CameronBrooks11/cubesat-pc104-kicad/breakout/CSK_Bus_Breakout.kicad_sch

## KiCad design breakout/CSK_Bus_Breakout.kicad_sch (2026-11-14)

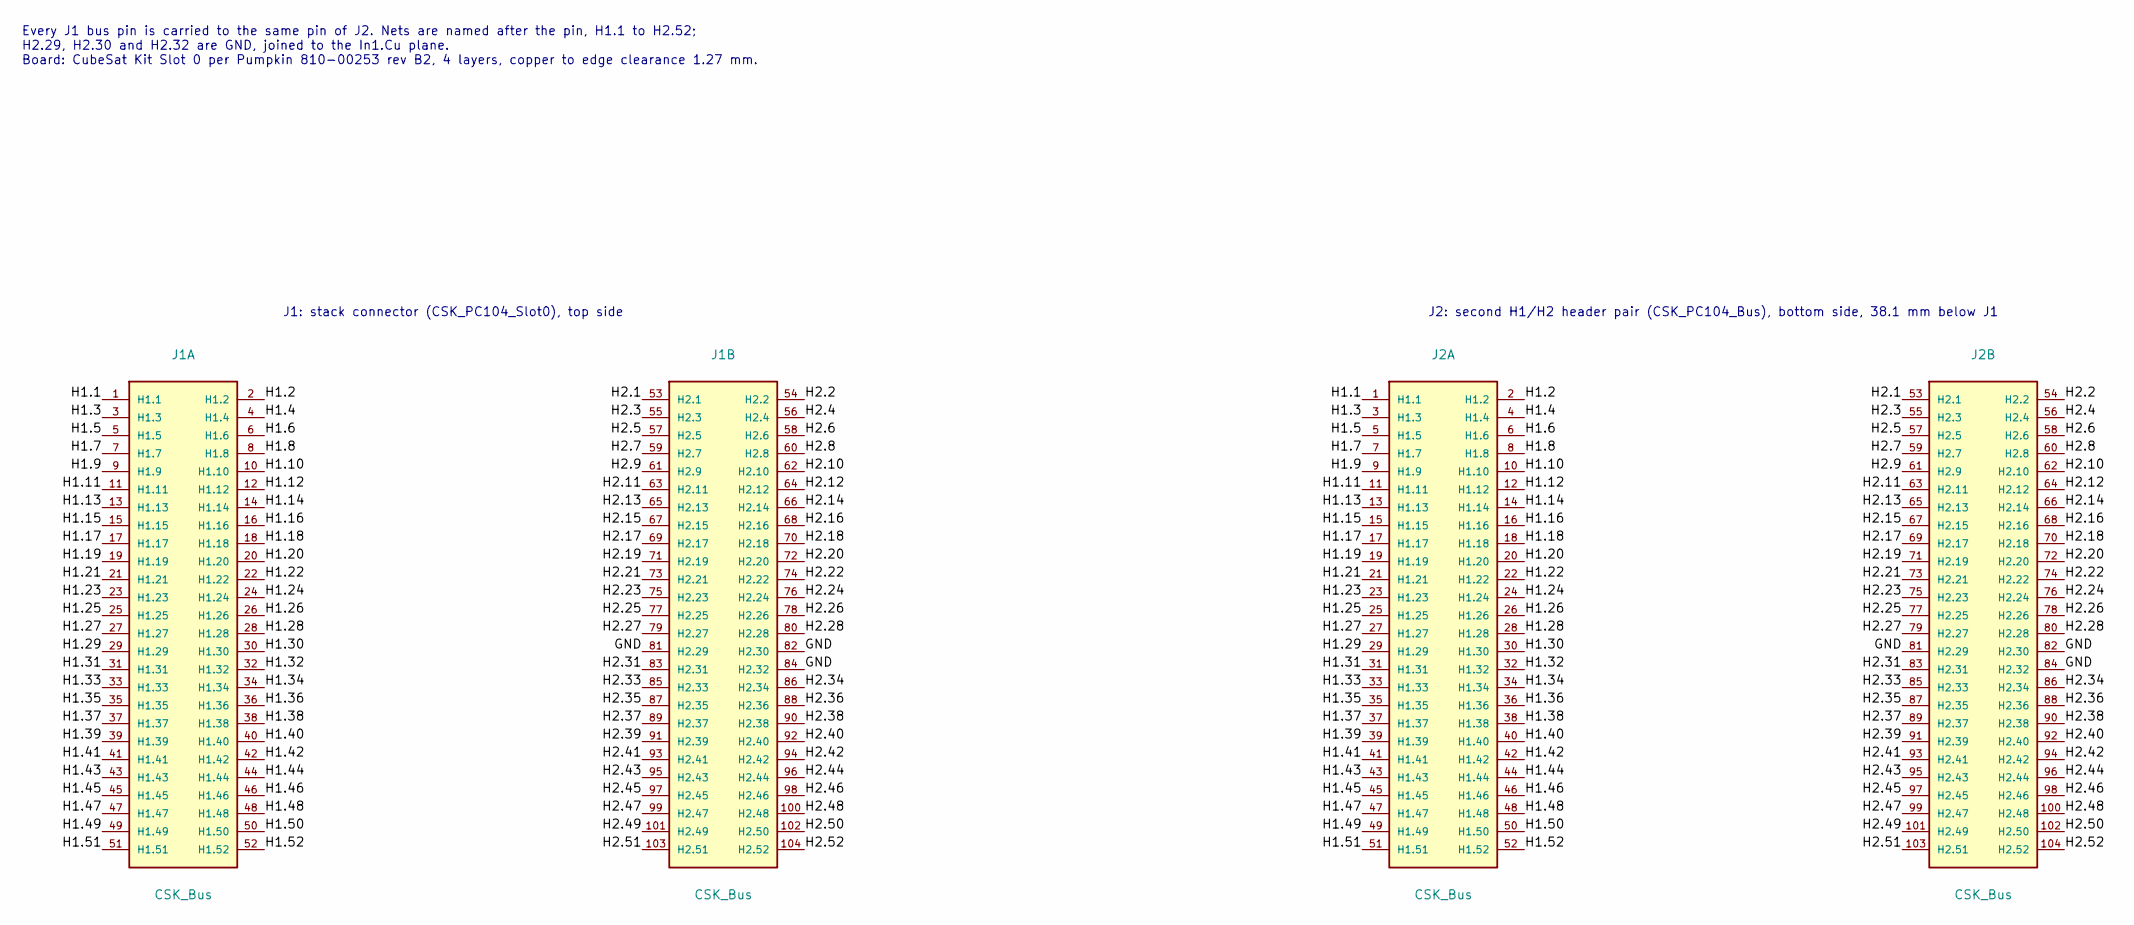
[picture p8: schematic CSK_Bus_Breakout.kicad_sch]

Parts:
J1: CSK_Bus; CSK_PC104_Slot0
J2: CSK_Bus; CSK_PC104_Bus

Connections:
GND: J1.81 (H2.29), J1.82 (H2.30), J1.84 (H2.32), J2.81 (H2.29), J2.82 (H2.30), J2.84 (H2.32)
H1.1: J1.1 (H1.1), J2.1 (H1.1)
H1.2: J1.2 (H1.2), J2.2 (H1.2)
H1.3: J1.3 (H1.3), J2.3 (H1.3)
H1.4: J1.4 (H1.4), J2.4 (H1.4)
H1.5: J1.5 (H1.5), J2.5 (H1.5)
H1.6: J1.6 (H1.6), J2.6 (H1.6)
H1.7: J1.7 (H1.7), J2.7 (H1.7)
H1.8: J1.8 (H1.8), J2.8 (H1.8)
H1.9: J1.9 (H1.9), J2.9 (H1.9)
H1.10: J1.10 (H1.10), J2.10 (H1.10)
H1.11: J1.11 (H1.11), J2.11 (H1.11)
H1.12: J1.12 (H1.12), J2.12 (H1.12)
H1.13: J1.13 (H1.13), J2.13 (H1.13)
H1.14: J1.14 (H1.14), J2.14 (H1.14)
H1.15: J1.15 (H1.15), J2.15 (H1.15)
H1.16: J1.16 (H1.16), J2.16 (H1.16)
H1.17: J1.17 (H1.17), J2.17 (H1.17)
H1.18: J1.18 (H1.18), J2.18 (H1.18)
H1.19: J1.19 (H1.19), J2.19 (H1.19)
H1.20: J1.20 (H1.20), J2.20 (H1.20)
H1.21: J1.21 (H1.21), J2.21 (H1.21)
H1.22: J1.22 (H1.22), J2.22 (H1.22)
H1.23: J1.23 (H1.23), J2.23 (H1.23)
H1.24: J1.24 (H1.24), J2.24 (H1.24)
H1.25: J1.25 (H1.25), J2.25 (H1.25)
H1.26: J1.26 (H1.26), J2.26 (H1.26)
H1.27: J1.27 (H1.27), J2.27 (H1.27)
H1.28: J1.28 (H1.28), J2.28 (H1.28)
H1.29: J1.29 (H1.29), J2.29 (H1.29)
H1.30: J1.30 (H1.30), J2.30 (H1.30)
H1.31: J1.31 (H1.31), J2.31 (H1.31)
H1.32: J1.32 (H1.32), J2.32 (H1.32)
H1.33: J1.33 (H1.33), J2.33 (H1.33)
H1.34: J1.34 (H1.34), J2.34 (H1.34)
H1.35: J1.35 (H1.35), J2.35 (H1.35)
H1.36: J1.36 (H1.36), J2.36 (H1.36)
H1.37: J1.37 (H1.37), J2.37 (H1.37)
H1.38: J1.38 (H1.38), J2.38 (H1.38)
H1.39: J1.39 (H1.39), J2.39 (H1.39)
H1.40: J1.40 (H1.40), J2.40 (H1.40)
H1.41: J1.41 (H1.41), J2.41 (H1.41)
H1.42: J1.42 (H1.42), J2.42 (H1.42)
H1.43: J1.43 (H1.43), J2.43 (H1.43)
H1.44: J1.44 (H1.44), J2.44 (H1.44)
H1.45: J1.45 (H1.45), J2.45 (H1.45)
H1.46: J1.46 (H1.46), J2.46 (H1.46)
H1.47: J1.47 (H1.47), J2.47 (H1.47)
H1.48: J1.48 (H1.48), J2.48 (H1.48)
H1.49: J1.49 (H1.49), J2.49 (H1.49)
H1.50: J1.50 (H1.50), J2.50 (H1.50)
H1.51: J1.51 (H1.51), J2.51 (H1.51)
H1.52: J1.52 (H1.52), J2.52 (H1.52)
H2.1: J1.53 (H2.1), J2.53 (H2.1)
H2.2: J1.54 (H2.2), J2.54 (H2.2)
H2.3: J1.55 (H2.3), J2.55 (H2.3)
H2.4: J1.56 (H2.4), J2.56 (H2.4)
H2.5: J1.57 (H2.5), J2.57 (H2.5)
H2.6: J1.58 (H2.6), J2.58 (H2.6)
H2.7: J1.59 (H2.7), J2.59 (H2.7)
H2.8: J1.60 (H2.8), J2.60 (H2.8)
H2.9: J1.61 (H2.9), J2.61 (H2.9)
H2.10: J1.62 (H2.10), J2.62 (H2.10)
H2.11: J1.63 (H2.11), J2.63 (H2.11)
H2.12: J1.64 (H2.12), J2.64 (H2.12)
H2.13: J1.65 (H2.13), J2.65 (H2.13)
H2.14: J1.66 (H2.14), J2.66 (H2.14)
H2.15: J1.67 (H2.15), J2.67 (H2.15)
H2.16: J1.68 (H2.16), J2.68 (H2.16)
H2.17: J1.69 (H2.17), J2.69 (H2.17)
H2.18: J1.70 (H2.18), J2.70 (H2.18)
H2.19: J1.71 (H2.19), J2.71 (H2.19)
H2.20: J1.72 (H2.20), J2.72 (H2.20)
H2.21: J1.73 (H2.21), J2.73 (H2.21)
H2.22: J1.74 (H2.22), J2.74 (H2.22)
H2.23: J1.75 (H2.23), J2.75 (H2.23)
H2.24: J1.76 (H2.24), J2.76 (H2.24)
H2.25: J1.77 (H2.25), J2.77 (H2.25)
H2.26: J1.78 (H2.26), J2.78 (H2.26)
H2.27: J1.79 (H2.27), J2.79 (H2.27)
H2.28: J1.80 (H2.28), J2.80 (H2.28)
H2.31: J1.83 (H2.31), J2.83 (H2.31)
H2.33: J1.85 (H2.33), J2.85 (H2.33)
H2.34: J1.86 (H2.34), J2.86 (H2.34)
H2.35: J1.87 (H2.35), J2.87 (H2.35)
H2.36: J1.88 (H2.36), J2.88 (H2.36)
H2.37: J1.89 (H2.37), J2.89 (H2.37)
H2.38: J1.90 (H2.38), J2.90 (H2.38)
H2.39: J1.91 (H2.39), J2.91 (H2.39)
H2.40: J1.92 (H2.40), J2.92 (H2.40)
H2.41: J1.93 (H2.41), J2.93 (H2.41)
H2.42: J1.94 (H2.42), J2.94 (H2.42)
H2.43: J1.95 (H2.43), J2.95 (H2.43)
H2.44: J1.96 (H2.44), J2.96 (H2.44)
H2.45: J1.97 (H2.45), J2.97 (H2.45)
H2.46: J1.98 (H2.46), J2.98 (H2.46)
H2.47: J1.99 (H2.47), J2.99 (H2.47)
H2.48: J1.100 (H2.48), J2.100 (H2.48)
H2.49: J1.101 (H2.49), J2.101 (H2.49)
H2.50: J1.102 (H2.50), J2.102 (H2.50)
H2.51: J1.103 (H2.51), J2.103 (H2.51)
H2.52: J1.104 (H2.52), J2.104 (H2.52)

Notes on the sheet:
J2: second H1/H2 header pair (CSK_PC104_Bus), bottom side, 38.1 mm below J1
Every J1 bus pin is carried to the same pin of J2. Nets are named after the pin, H1.1 to H2.52; H2.29, H2.30 and H2.32 are GND, joined to the In1.Cu plane. Board: CubeSat Kit Slot 0 per Pumpkin 810-00253 rev B2, 4 layers, copper to edge clearance 1.27 mm.
J1: stack connector (CSK_PC104_Slot0), top side
