CameronBrooks11/cubesat-pc104-kicad/(commit log)

2026-11-13 chore: remove backups, credit SPEL, rename to cubesat-pc104-kicad
    The first of four PRs to finish this repo: remove backups and caches, credit SPEL, and say where things stand. The board, library and template follow in their own PRs.
    ## Removed
    - 16 Eagle autosaves of the with_connector board (`.b#1`–`.b#9`, `.s#1`–`.s#7`).
    - That board's `.rar`. It holds byte-identical copies of the tracked `.sch` and `.brd` (sha256 compared).
    - 3 KiCad backup zips, `PC104/fp-info-cache`, and `RepoTree.txt`, a printout of the folder tree on the drive the files came from.
    A `.gitignore` keeps these out from now on.
    Kept: the PicoBlade `.rar`. Its `.brd` routes OUT1_3V3 and OUT2_3V3 to a `V_OUT` conne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
2026-11-13 fix(breakout): KiCad 10 format, schematic net names, supply pins joined
    Fix what can be fixed on the stack breakout board without placement work, and say what's left for the editor.
    ## Results
    KiCad 10.0.6. DRC was run with `--refill-zones` and `--schematic-parity`.
    | | Before | After |
    | --- | --- | --- |
    | ERC | 0 | 0 |
    | Schematic parity | 203 (199 net names, 4 mounting holes) | 0 |
    | Unconnected items | 3 | 0 |
    | DRC violations | 28 | 12 |
    ## Commits
    1. **KiCad 10 format.** The schematic, board and project libraries are saved with KiCad's upgrade commands. Nothing else changed: before and after, the board and schematic group the same pads into the same 99 nets, and DRC gives the sam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
    [StackBreakoutConnection_4layers_V1.0.kicad_pcb, StackBreakoutConnection_4layers_V1.0.kicad_sch]
2026-11-13 feat(library): CubeSat Kit Slot 0 footprint, CSK_Bus and corrected SUCHAI symbols
    Replace SPEL's Payload library with a CubeSat_PC104 library checked against Pumpkin's CubeSat Kit PCB specification (810-00253 rev B2, 2018-11-08).
    ## Parts
    | Part | What it is |
    | --- | --- |
    | `CSK_PC104_Slot0` footprint | Base "Slot 0" user module: outline, H1/H2, 4 holes, keepouts. Origin at H1 pin 1. |
    | `CSK_Bus` symbol | Generic bus: unit A is H1 (pins 1–52), unit B is H2 (53–104), all passive. |
    | `SUCHAI_Payload` symbol | SPEL's SUCHAI pinout, pin types corrected. |
    Both symbols use `CubeSat_PC104:CSK_PC104_Slot0`.
    ## Why SPEL's footprint was replaced
    I aligned SPEL's `PC104-Standard` with the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
2026-11-13 feat(template): CubeSat Kit Slot 0 project template and just check
    Add a KiCad 10 project template for a CubeSat Kit user module, plus a `just check` that keeps it in step with the library.
    ## The template
    `templates/CubeSat_PC104_Slot0` is a "New Project from Template" project, set up like the RPi_Hat_Template ones:
    - **Board:** the `CSK_PC104_Slot0` footprint as J1 on a 2-layer board, giving the Slot 0 outline, H1/H2, the mounting holes and the three keepouts. Copper to edge clearance is set to the spec's recommended 1.27 mm.
    - **Schematic:** `CSK_Bus` units A (H1) and B (H2) as J1, every pin unconnected, with a note saying what to do.
    - **Libraries:** the template's own copy of the `Cu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
    [CubeSat_PC104_Slot0.kicad_pcb, CubeSat_PC104_Slot0.kicad_sch]
2026-11-13 fix(breakout): CubeSat Kit Slot 0 outline, keepouts and filled pours
    Put the stack breakout board on the CubeSat Kit Slot 0 outline, which SPEL's outline overran by up to 2.08 mm.
    ## How
    The board's mounting holes and stack headers were already where the spec puts them, so only the outline needed moving.
    - **Placement.** Rotated 90°, the `CSK_PC104_Slot0` footprint's four holes land on the board's within 0.0025 mm. The 52 pads of J1 and the 52 of J2, the stack headers, then sit on the footprint's pins within 0.0225 mm. J3/J4 are the offset copies, which the spec doesn't cover.
    - **Outline.** The board's 24 SPEL Edge.Cuts segments are replaced by the footprint's 40-edge outline at that pl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
    [StackBreakoutConnection_4layers_V1.0.kicad_pcb]
2026-11-13 ci: run just check in KiCad 10.0.6; add just fab
    Add CI for the library and template, and a `just fab` recipe for fabrication files.
    ## CI
    `.github/workflows/check.yml` runs `just check` in the official `kicad/kicad:10.0.6` image (Docker Hub tag dated 2026-09-22, linux/amd64) on every pull request and push to `main`. 10.0.6 is the release the files were last saved with. The job:
    1. installs `just`;
    2. prints the `kicad-cli` version;
    3. runs `just check`.
    To show it fails when it should, I pushed a commit that changed the library without syncing the template, then reverted it. Tree at `c9f5a2b` = tree at `6ba10cc`.
    | Run | Commit | Result |
    | 43474392592 | `6ba10cc` |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
2026-11-13 fix(breakout): clear DRC, enlarge pours, add a 4-layer stackup (#8)
    Finishes SPEL's stack breakout board without redesigning it: the board goes from 15 DRC violations to none, and it gains a stackup.
    KiCad 10.0.6, `pcb drc --severity-all --schematic-parity --refill-zones`:
    | Violations | 15 | 0 |
    | Unconnected items | 0 | 0 |
    | Schematic parity issues | 0 | 0 |
    ## Changes
    - **Tracks:** all 104 horizontal bus tracks moved to midway between pad rows (1.27 mm above the row below), with their 45° stubs recomputed. The top F.Cu track had cut 0.008 mm into the top-left mounting hole's keepout.
    - **Silkscreen:** the mounting-hole footprint drops its two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
    [StackBreakoutConnection_4layers_V1.0.kicad_pcb, StackBreakoutConnection_4layers_V1.0.kicad_sch]
2026-11-13 feat: add a Slot 1 footprint and template; document stack conventions (#7)
    Add Pumpkin's extended Slot 1 pattern beside Slot 0, as a footprint and a project template, and document the two ways of mounting the stack connectors.
    ## Slot 1
    **`CSK_PC104_Slot1` footprint.** Generated from the specification's Slot 1 DXF (810-00253 rev B2), by the same generator as Slot 0, now parameterised by slot. Re-running it for Slot 0 gives output identical to the committed one apart from UUIDs.
    - **Geometry:** holes and all 104 pins land on the DXF's to 0.0000 mm.
    - **Outline:** the DXF's outline closes once the clipped pad ring at the top-right hole is left out. There are no keepout boxes and no 2nd-swit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
    [CubeSat_PC104_Slot1.kicad_pcb, CubeSat_PC104_Slot1.kicad_sch]
2026-11-13 chore(license): CERN-OHL-P-2.0 for the library and templates; redraw SUCHAI_Payload (#9)
    Relicenses the library, templates and tooling under CERN-OHL-P-2.0 so outside teams can build boards from them without GPL obligations. SPEL's breakout and Eagle designs stay GPL-3.0.
    ## License split
    | What | License |
    | Library, both templates, `tools/`, CI, docs | CERN-OHL-P-2.0 (root `LICENSE`) |
    | `PC104/` (stack breakout), `Eagle/`, `img/breakout_*.png` | GPL-3.0 (`PC104/LICENSE`, `Eagle/LICENSE`) |
    The breakout keeps SPEL's schematic, placement and routing, so it stays under their license. SPEL's Eagle files also embed SparkFun library parts with their own CC BY-SA 4.0 notice; the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
    [CubeSat_PC104_Slot0.kicad_sch, CubeSat_PC104_Slot1.kicad_sch, suchai_pins.csv]
2026-11-13 feat(tools): footprint generator; check the breakout, ERC and symbols in CI (#13)
    Puts the footprint generator in the repo and widens `just check` to cover the stack breakout, ERC and the symbol generator.
    Replaces #10, which GitHub closed when its base branch (#9) was deleted on merge. Same branch, same commits.
    ## Footprint generator
    The generator for `CSK_PC104_Slot0`/`Slot1` was never committed, so nobody could regenerate or re-check the footprints. It now lives in `tools/genfp.py`, with its DXF reader `tools/dxfloops.py`.
    `just footprints spec=<folder>`:
    1. regenerates both footprints from Pumpkin's DXFs;
    2. normalises them with `kicad-cli fp upgrade`;
    3. diffs them against `KiCad/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
2026-11-13 feat(breakout): replace SPEL's breakout with a generated bus breakout (#12)
    Replaces SPEL's GPL-3.0 stack breakout and Eagle files with a new bus breakout, designed from this repo's own template and library. The whole repo becomes CERN-OHL-P-2.0.
    Stacked on #10, which is stacked on #9. Merge in order: #9, then #10, then this one.
    <p>
    <img src="https://raw.githubusercontent.com/CameronBrooks11/cubesat-pc104-kicad/feat/clean-breakout/img/breakout_top.png" alt="Top" width="48%" />
    <img src="https://raw.githubusercontent.com/CameronBrooks11/cubesat-pc104-kicad/feat/clean-breakout/img/breakout_bottom.png" alt="Bottom" width="48%" />
    </p>
    ## New board: `breakout/CSK_Bus_Breakout`
    Generated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
    [2086592440.stp, CSK_Bus_Breakout.kicad_pcb, CSK_Bus_Breakout.kicad_sch, StackBreakoutConnection.brd, StackBreakoutConnection.sch, StackBreakoutConnection_4layers_V1.0.brd, StackBreakoutConnection_4layers_V1.0.kicad_pcb, StackBreakoutConnection_4layers_V1.0.kicad_sch]
2026-11-13 ci(release): just dist, a tag-driven release workflow and a changelog (#14)
    Release machinery for v1.0.0. Nothing is tagged or published by this PR.
    ## `just dist <version>`
    Builds four assets into `dist/`:
    | Asset | Contents |
    | `CubeSat_PC104-<v>.zip` | symbol + footprint library, LICENSE |
    | `cubesat-pc104-templates-<v>.zip` | both templates, LICENSE |
    | `CSK_Bus_Breakout-<v>.zip` | breakout KiCad project, LICENSE |
    | `CSK_Bus_Breakout-fab-<v>.zip` | Gerbers + drill from `just fab`, which refuses unless DRC is clean |
    `.kicad_prl` files are stripped from every zip.
    Run locally up to the fab step: each of the first three zips has exactly one `LICENSE` and no `.kicad_prl`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
2026-11-14 fix: centre boards and sheets on their pages; KiCad 10 project files (#15)
    Puts every board and sheet in a standard place on its page, and saves the project files in KiCad 10's own format.
    ## Templates
    **Board position.** Both template boards now have H1 pin 1 at (116.84, 68.58) mm, on the 0.1 in grid. Before, J1 sat at (100, 100), which put each board low on the A4 page and close to the title block. Now each board spans about x 103–193 and y 56–152 mm, centred on the page and clear of the title block. Slot 0's keepouts, which KiCad stores in board coordinates, moved with the footprint.
    **Project files.** The `.kicad_pro` files were in an older format, so KiCad 10 rewrote them on firs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
    [CSK_Bus_Breakout.kicad_pcb, CSK_Bus_Breakout.kicad_sch, CubeSat_PC104_Slot0.kicad_pcb, CubeSat_PC104_Slot1.kicad_pcb]
2026-11-14 docs: name the KiCad version the templates need (#16)
    Creating a project from a template folder fails in the KiCad 10 patch before 10.0.6 and works in 10.0.6, which CI also uses. The README now says so where it lists releases and in the template steps, and mentions KICAD_USER_TEMPLATE_DIR for listing the templates permanently.
2026-11-14 fix: save project files as KiCad 10.0.6 writes them (#17)
    KiCad 10.0.6 writes net_settings.net_colors and netclass_assignments as {} where the earlier patch wrote null, so opening a template rewrote those two lines. All three project files now use {}; the breakout's generator copies the Slot 0 one.
